PrBelamine/desk-watch-joy-student/docs/photos/joy_student_poster.jpg

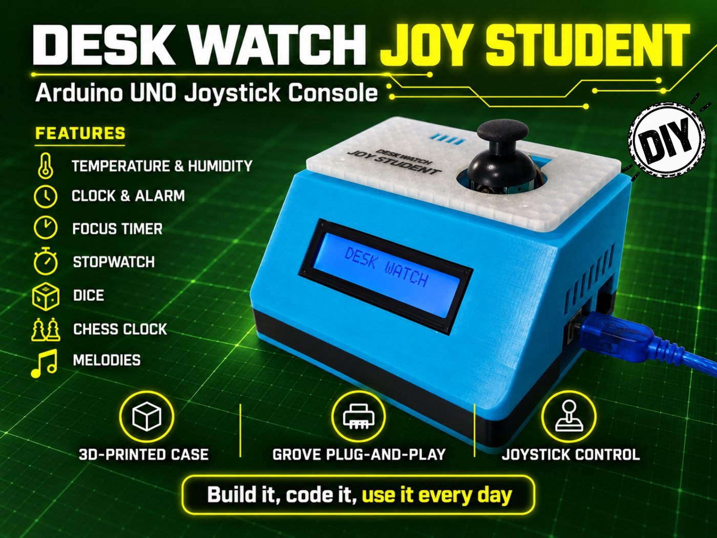
docs/photos/joy_student_poster.jpg
