PrBelamine/desk-watch-joy-student/docs/photos/joy_student_parts.jpg

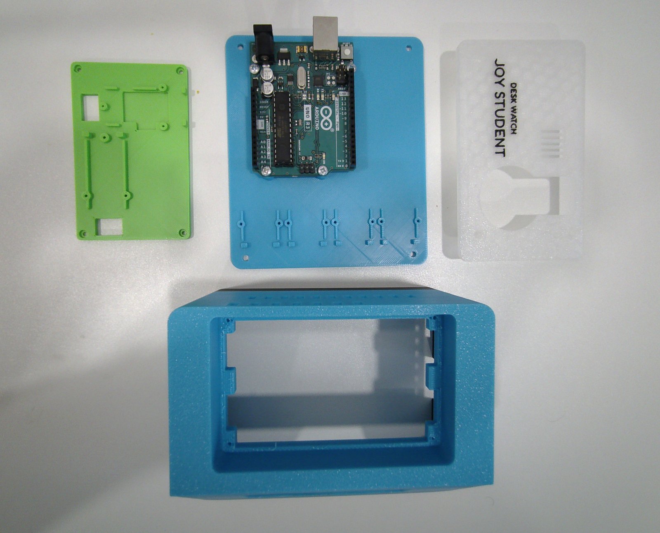
docs/photos/joy_student_parts.jpg
