PrBelamine/desk-watch-joy-student/docs/photos/joy_student_cover.jpg

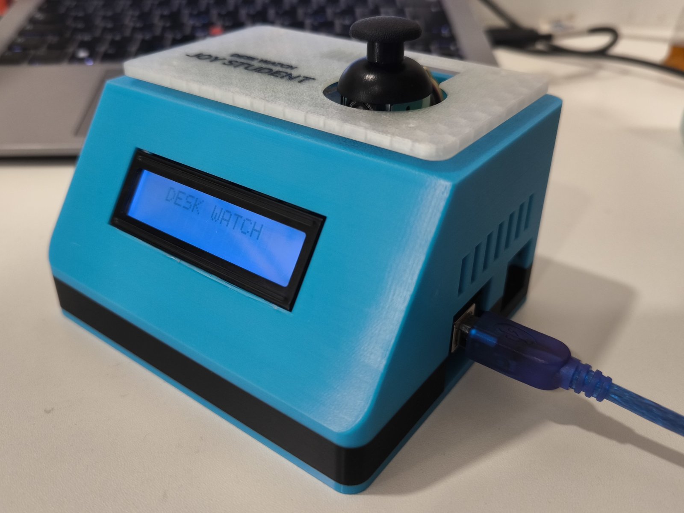
docs/photos/joy_student_cover.jpg
