PrBelamine/desk-watch-joy-student/docs/wiring_EN.png

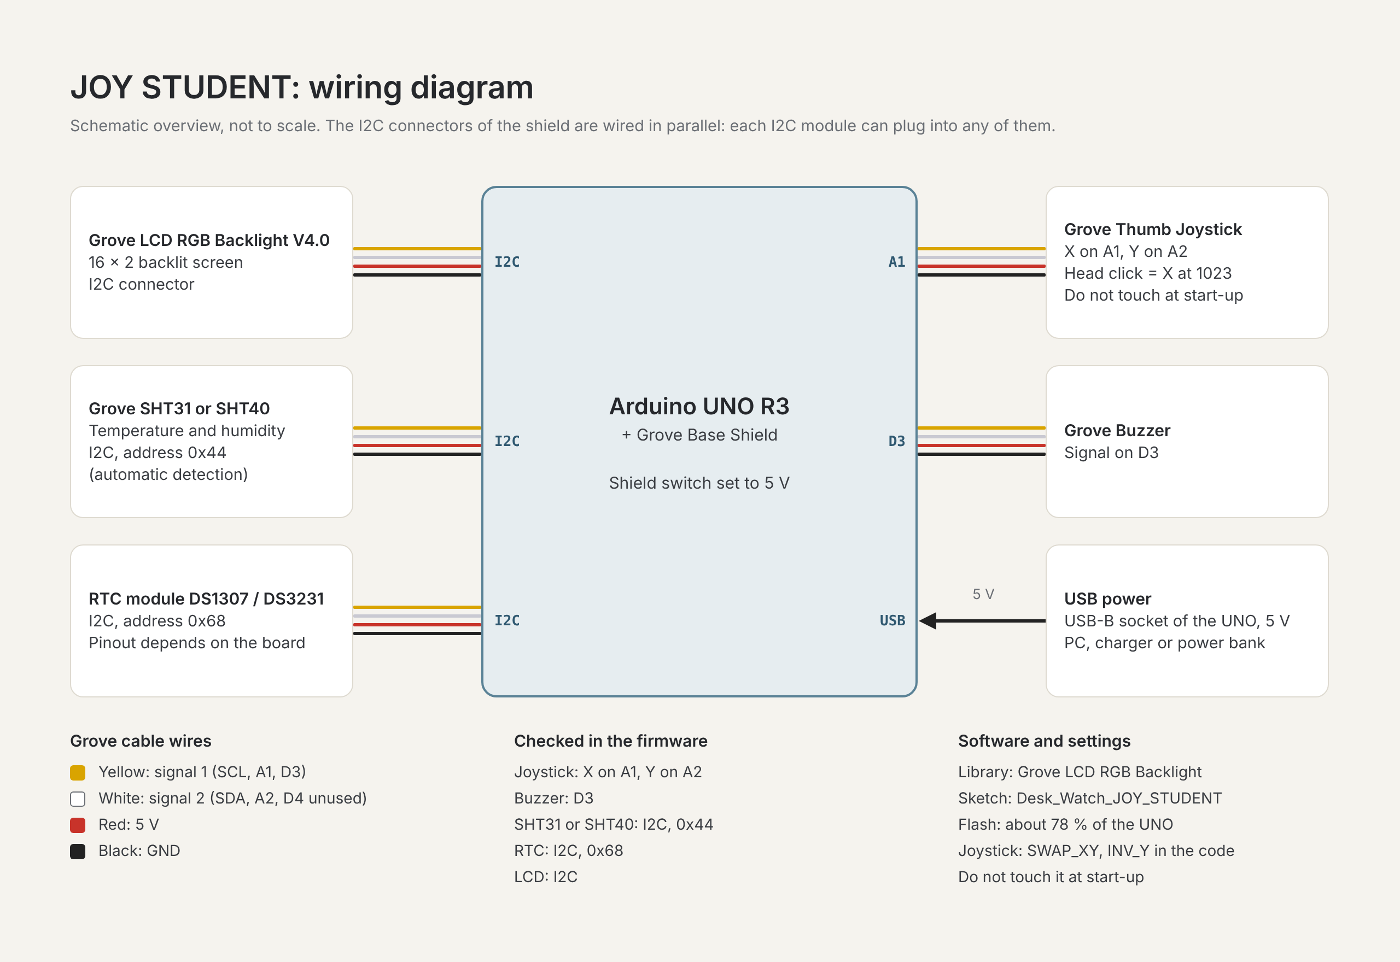
docs/wiring_EN.png
