PrBelamine/desk-watch-joy-student/docs/wiring_FR.png

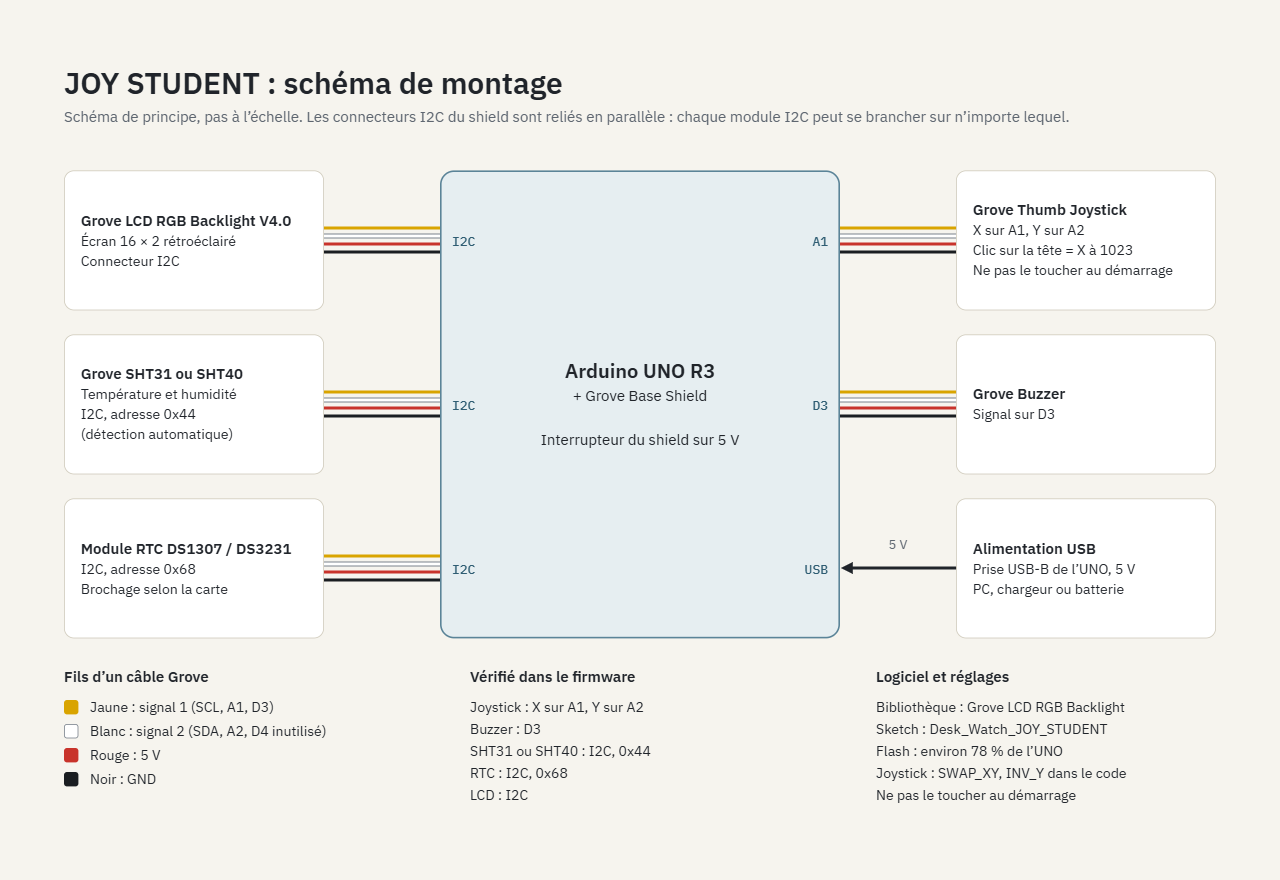
docs/wiring_FR.png
