PrBelamine/desk-watch-joy-student/(commit log)

2026-10-25 Add guides and wiring diagrams
2026-10-25 RTC is required: fix header comment (EN)
    [Desk_Watch_JOY_STUDENT_Edition_EN.ino]
2026-10-25 RTC is required: fix header comment (FR)
    [Desk_Watch_JOY_STUDENT_Edition_FR.ino]
2026-10-28 JOY STUDENT: user guides and README updated for five volume levels, timer colours and default brightness
